EmilCarvajal/Robot-Croupier/01_Diseños/Componentes Hardware.JPG

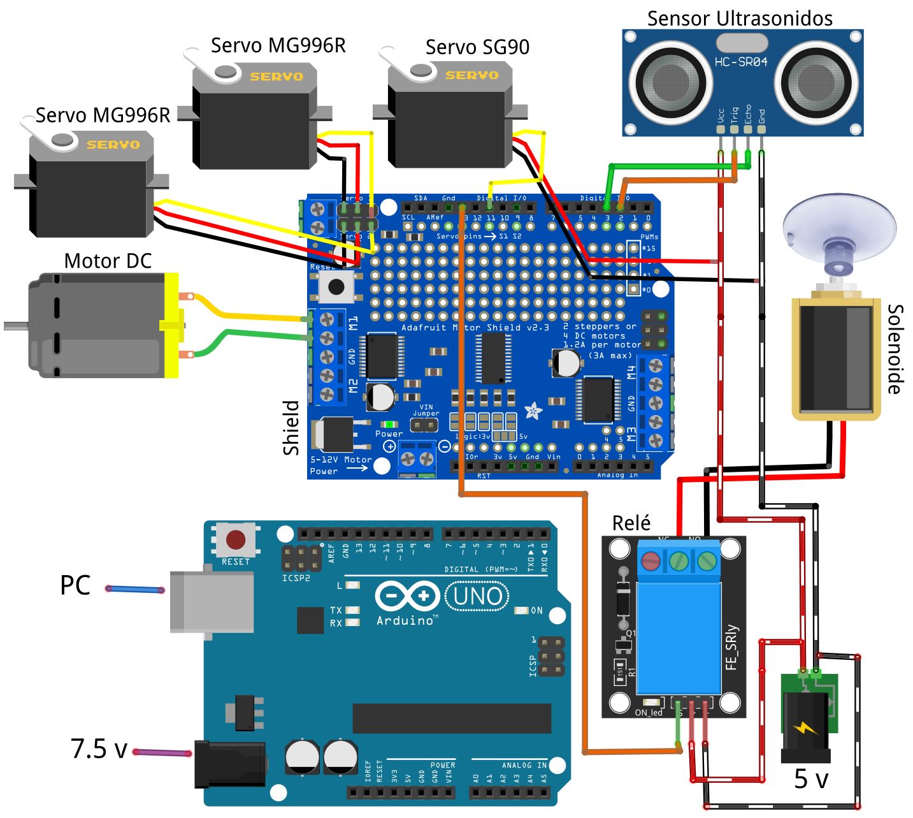
01_Diseños/Componentes Hardware.JPG
