EmilCarvajal/Robot-Croupier/01_Diseños/Diagrama Conceptual Software Deal-AI.JPG

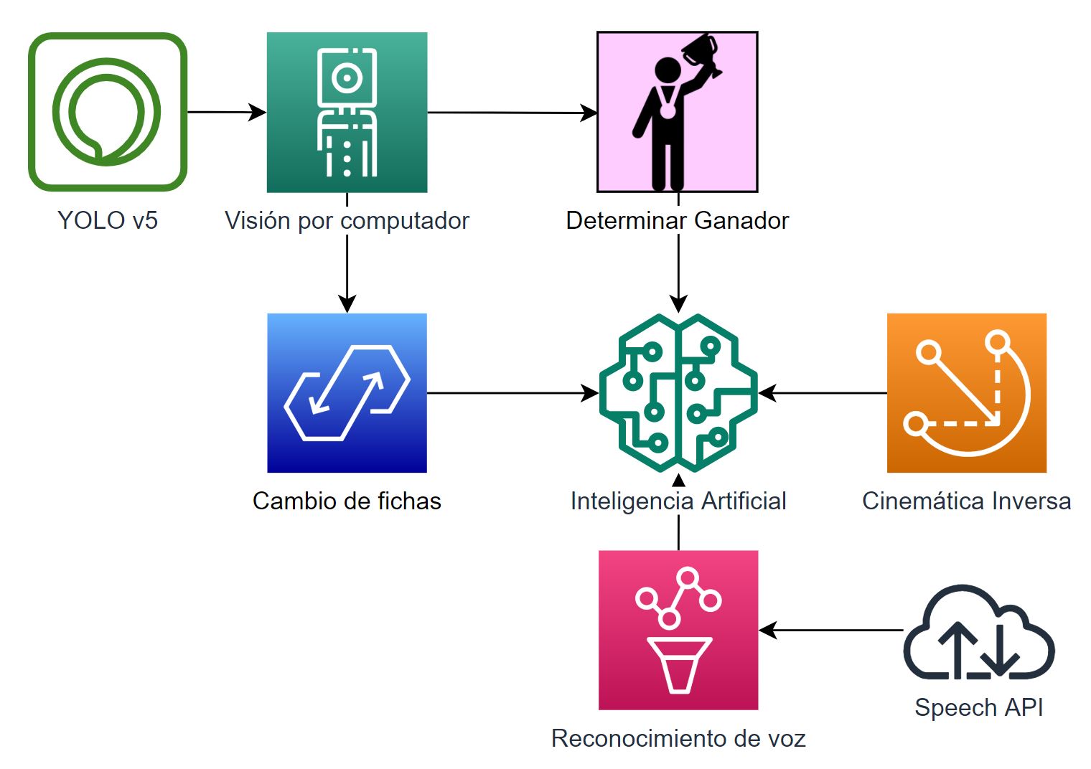
01_Diseños/Diagrama Conceptual Software Deal-AI.JPG
