EmilCarvajal/Robot-Croupier/README.md

# Robot-Croupier
Robot que actúa como Croupier o Dealer en el juego del póquer, concretamente la modalidad de Texas Holdem. Deal AI (Dealer with Artificial Intelligence) es un robot que permite preparar el inicio de la partida repartiendo cartas y fichas a los jugadores.
