EmilCarvajal/Robot-Croupier/01_Diseños/Diseño Objeto Volteador Cartas.JPG

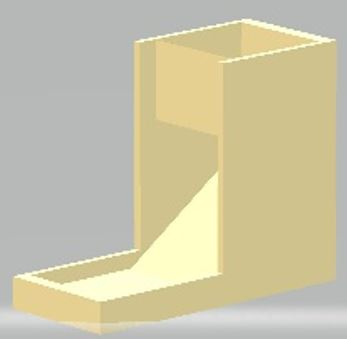
01_Diseños/Diseño Objeto Volteador Cartas.JPG
