EmilCarvajal/Robot-Croupier/01_Diseños/Diseño Objeto Volteador Cartas STL.stl

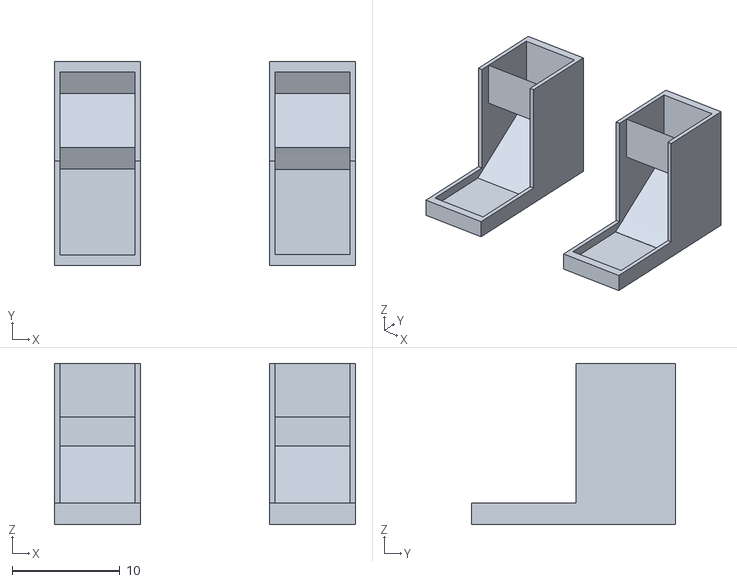
[picture p19: CAD file, 2022-06-28]
01_Diseños/Diseño Objeto Volteador Cartas STL.stl
28.0 x 19.0 x 15.0
