EmilCarvajal/Robot-Croupier/01_Diseños/Diseño Chasis STL.stl

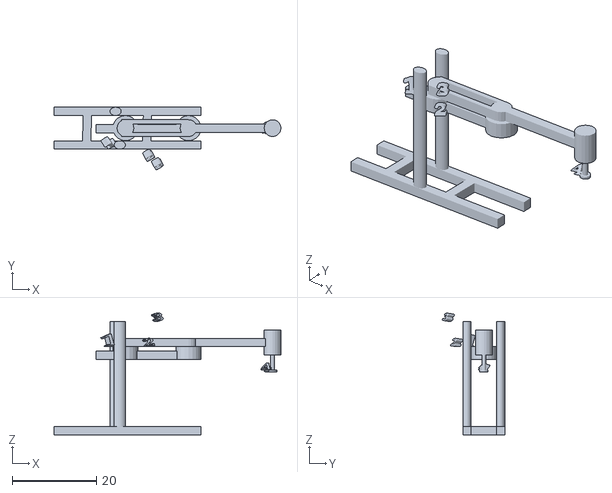
[picture p20: CAD file, 2022-06-28]
01_Diseños/Diseño Chasis STL.stl
54.0 x 14.9 x 29.0
