EmilCarvajal/Robot-Croupier/(list of files, drawings)

Other design files:
01_Diseños/Componentes Hardware.fzz
01_Diseños/ComponentesHardware.fzz
